Lirrak/Project-Robotics-LiDar/LiDar/chassis_3d_view.html

✓

# Robot Chassis (Fixed Clearance)

Đã Mở Rộng Khe Khoét 76mm x 50mm

Kích Thước Khe Cắt Đã Sửa

Chiều Dài Khe (Z)

76 mm

Độ Sâu Khe (X)

50 mm

Khe Hở An Toàn

5.5 mm (Mọi hướng)

Trạng Thái Chèn Khung

0% (Hoàn Toàn Không Cấn)

Hiển Thị Thành Phần

Tầng Đáy Đã Cắt Khe Rộng

Tầng Đỉnh (Top Deck)

Động Cơ & Bánh Xe

Pin 12V Li-ion

Mạch Driver TB6612 & XL4015

Raspberry Pi 3B+ & ESP32

RPLiDAR A1 Sensor

Tải File STL Mới Nhất

📦 Full Robot Assembly STL ⬇ 📄 Tầng Đáy (chassis_bottom.stl) ⬇

Center Camera Auto Rotate Wireframe Mode

✔ Đã xử lý dứt điểm lỗi cấn bánh xe:

- Mở rộng khe cắt theo chiều dài từ 36mm lên **76mm** (bánh xe 65mm có khoảng hở 5.5mm trước & sau).
- Độ sâu khe khoét vào lòng khung **50mm** giúp bánh xe 25mm và gá động cơ lọt hẳn vào trong.
