Lirrak/Project-Robotics-LiDar/PCB Design/Simulation/TCB6612/sim_driver_motor.kicad_sch

## KiCad design PCB Design/Simulation/TCB6612/sim_driver_motor.kicad_sch (2026-09-14)

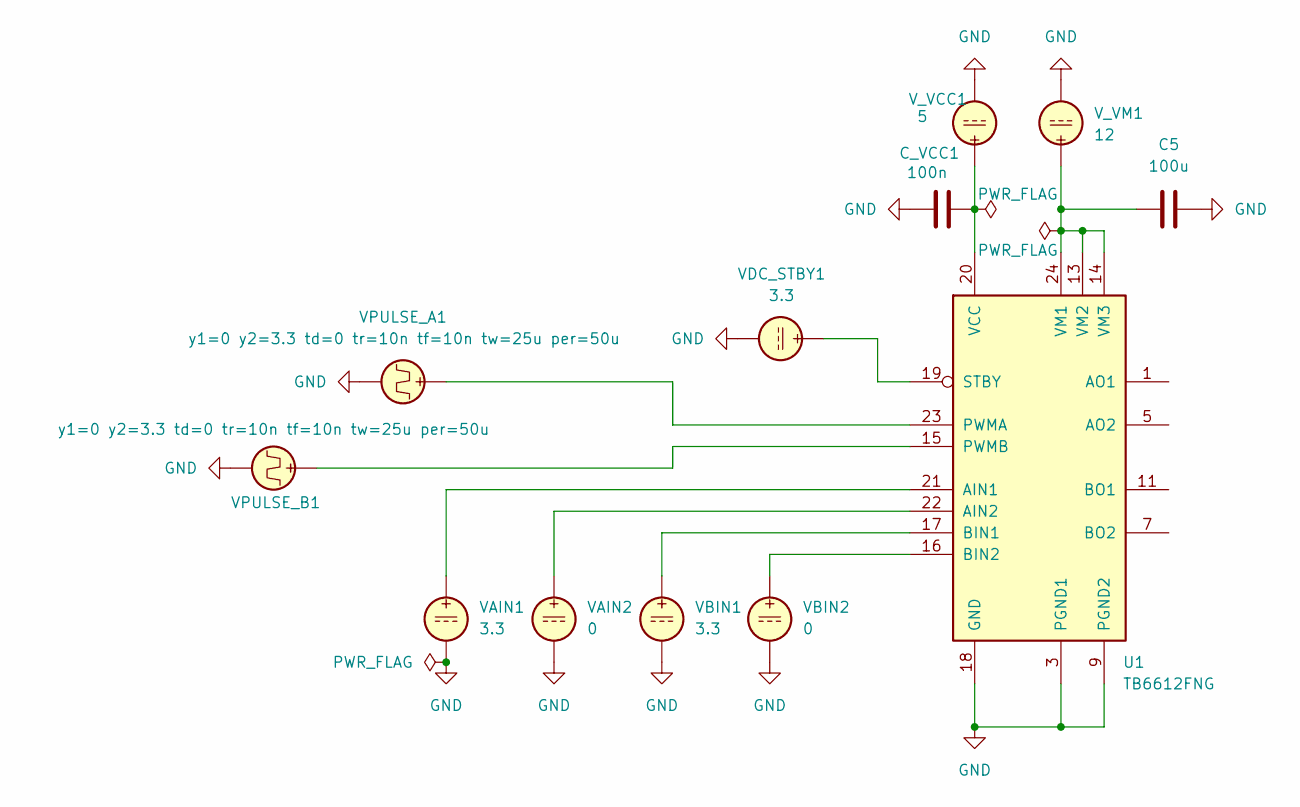
[picture p2: schematic sim_driver_motor.kicad_sch]

Parts:
C5: 100u
C_VCC1: 100n
U1: TB6612FNG; SSOP-24_5.3x8.2mm_P0.65mm
VAIN1: 3.3
VAIN2: 0
VBIN1: 3.3
VBIN2: 0
VDC_STBY1: 3.3; TQFP-44_10x10mm_P0.8mm
VPULSE_A1: TQFP-44_10x10mm_P0.8mm
VPULSE_B1: (no value)
V_VCC1: 5
V_VM1: 12

Connections:
GND: C5.2, C_VCC1.1, U1.3 (PGND1), U1.4 (PGND1), U1.9 (PGND2), U1.10 (PGND2), U1.18 (GND), VAIN1.2, VAIN2.2, VBIN1.2, VBIN2.2, VDC_STBY1.2, VPULSE_A1.2, VPULSE_B1.2, V_VCC1.2, V_VM1.2
unnamed: C5.1, U1.13 (VM2), U1.14 (VM3), U1.24 (VM1), V_VM1.1
unnamed: C_VCC1.2, U1.20 (VCC), V_VCC1.1
unnamed: U1.1 (AO1), U1.2 (AO1)
unnamed: U1.5 (AO2), U1.6 (AO2)
unnamed: U1.7 (BO2), U1.8 (BO2)
unnamed: U1.11 (BO1), U1.12 (BO1)
unnamed: U1.15 (PWMB), VPULSE_B1.1
unnamed: U1.16 (BIN2), VBIN2.1
unnamed: U1.17 (BIN1), VBIN1.1
unnamed: U1.19 (STBY), VDC_STBY1.1
unnamed: U1.21 (AIN1), VAIN1.1
unnamed: U1.22 (AIN2), VAIN2.1
unnamed: U1.23 (PWMA), VPULSE_A1.1
