Lirrak/Project-Robotics-LiDar/(commit log)

2026-07-29 feat: Initial release of Autonomous SLAM Robot (RPi 3B+, ESP32, LiDAR, 3D STL CAD Models & Web UI)
    [chassis_bottom.stl, chassis_top.stl, full_robot_chassis.stl, lidar_mount.stl, motor_holder.stl]
2026-09-12 Create 3d cad
2026-09-12 Add new file CAD/STL with initial content
2026-09-12 Delete stl_files directory
    Xóa bỏ cũ
    [chassis_bottom.stl, chassis_top.stl, full_robot_chassis.stl, lidar_mount.stl, motor_holder.stl]
2026-09-14 Create Simulation PCB
2026-09-14 Create PCB Design
    Tạo folder cho PCB Design
2026-09-14 Bổ sung README cho PCB
2026-09-14 Create Motor Driver TB6612
2026-09-14 Add project report for TB6612 simulation in KiCad
    Added detailed project report on TB6612 motor driver simulation and packaging model in KiCad SPICE, including troubleshooting steps and lessons learned.
2026-09-14 Delete 3d cad
    Dư nên xóa nhé
2026-09-15 Add detailed README for STM32F103C8T6 motor control
    This README documents the design process, review, and simulation of the schematic for the GA25 motor control module using STM32F103C8T6 and TB6612FNG. It includes project goals, architecture, component values, identified errors, SPICE simulations, automation efforts, and current status.
2026-09-15 Update motor type from GA25 to JGA25 in README
2026-09-18 Update LiDAR viewer and server
2026-09-18 Organize LiDAR tools into LiDar folder
2026-09-20 Cập nhật lại address cho lidar-server, ngoài ra cài đặt docker ubuntu 24.04 để cài ros2
2026-09-27 Cập nhật: Nâng RAM của Pi3 lên 2GB RAM Cập nhật websocket của cổng 9090 Đã cho LiDar nhận dữ liệu qua ROS2 Tạo service mới để chạy LiDar thông qua ROS2
2026-09-27 Sửa lỗi service không kết nối được với LiDar
