Lirrak/Project-Robotics-LiDar/(notices)

Notices in the files:
README.md:
License: MIT
